cadet-salzburg/EMGShield/README.md

EMGShield
=========

This project deals with the bio signal EMG (Electromyogram) and its potential as a control signal in connection with the Microcontroller-platform Arduino. The platform offers different pluggable modules, so called Shields, where unfortunately a professional EMG-Shield is missing. Due to this fact a first EMG-Shield prototype was developed. This process included the simulation of the electrical circuits, the implementation of these circuits on a breadboard and finally the verification. For this, a ping-pong-game was modified to test the ability of the EMG-signal as control-input. The test-application showed that it’s possible to control a ping-pong-game quite comfortable just by the power of a muscle. This underlines the high controlling-potential of the EMG-signal and motivates for further developments. Consequently, the circuit board, shown in our first video, has now been integrated to an Arduino Shield. The wiring and the software will soon be available online.

credits: Dieter Steininger, Michael Platz, Roland Haring, Christopher Lindinger, Veronika Pauser, Roland Aigner, Otto Naderer

http://www.cadet.at/2012/04/17/emg-shield/

License
=========

CADET - Center for Advances in Digital Entertainment Technologies
Copyright 2011 University of Applied Science Salzburg / MultiMediaTechnology & Ars Electronica Futurelab

http://www.cadet.at
http://multimediatechnology.at
http://research.aec.at

Licensed under the Apache License, Version 2.0 (the "License");
you may not use this file except in compliance with the License.
You may obtain a copy of the License at

http://www.apache.org/licenses/LICENSE-2.0

Unless required by applicable law or agreed to in writing, software
distributed under the License is distributed on an "AS IS" BASIS,
WITHOUT WARRANTIES OR CONDITIONS OF ANY KIND, either express or implied.
See the License for the specific language governing permissions and
limitations under the License.

CADET - Center for Advances in Digital Entertainment Technologies
funded by the Austrian Research Promotion Agency (http://www.ffg.at)
