cadet-salzburg/EMGShield/CAD/EMG_Shield_v.1.2.brd

## EAGLE design CAD/EMG_Shield_v.1.2.brd (2012-10-18)

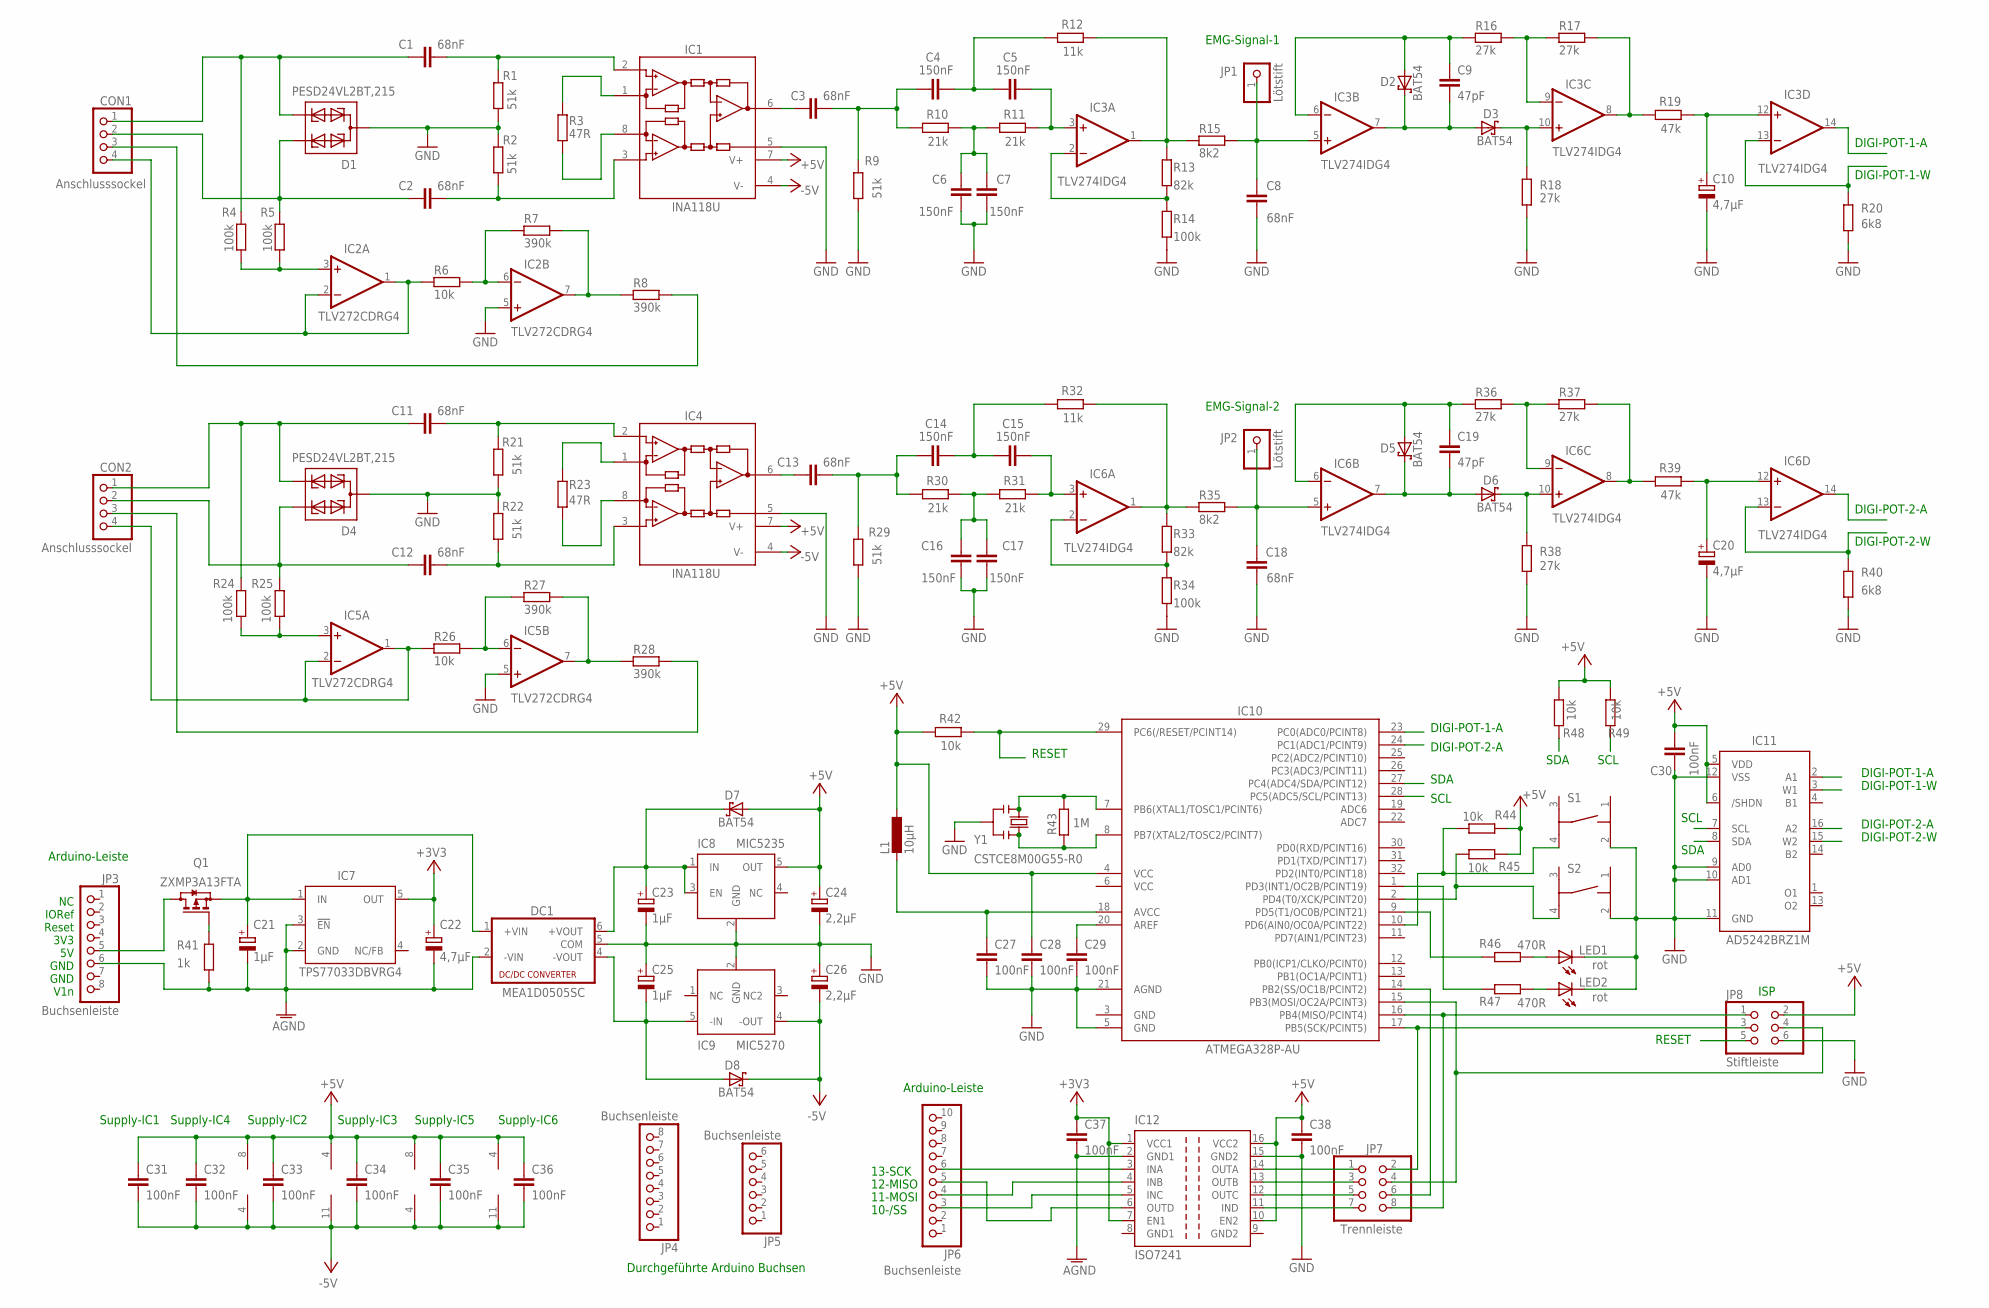
[picture p1: schematic EMG_Shield_v.1.2.sch]

Parts:
C1, C2, C3, C8, C11, C12, C13, C18: 68nF; C0603
C4, C5, C6, C7, C14, C15, C16, C17: 150nF; C0603
C9, C19: 47pF; C0603
C10, C20, C22: 4,7µF; CT3216
C21, C23, C25: 1µF; CT3216
C24, C26: 2,2µF; CT3216
C27, C28, C29, C30, C31, C32, C33, C34, C35, C36, C37, C38: 100nF; C0603
CON1, CON2: Anschlusssockel; 1X04/90
D1, D4: PESD24VL2BT,215; SOT23
D2, D3, D5, D6, D7, D8: BAT54; SOT23
DC1: MEA1D0505SC; NMA
IC1, IC4: INA118U; SO08
IC2, IC5: TLV272CDRG4; SO08
IC3, IC6: TLV274IDG4; SO14
IC7: TPS77033DBVRG4; SOT23-DBV
IC8: MIC5235; SOT23-5
IC9: MIC5270; SOT23-5
IC10: ATMEGA328P-AU; TQFP32-08
IC11: AD5242BRZ1M; SOIC16N
IC12: ISO7241; SO-16DW
JP1, JP2: Lötstift; 1X01
JP3, JP4: Buchsenleiste; SMARTPRJ_1X08-TH
JP5: Buchsenleiste; SMARTPRJ_1X06-TH
JP6: Buchsenleiste; SMARTPRJ_1X10
JP7: Trennleiste; 2X04
JP8: Stiftleiste; 2X03
L1: 10µH; R0805
LED1, LED2: rot; CHIP-LED0805
Q1: ZXMP3A13FTA; SOT23
R1, R2, R9, R21, R22, R29: 51k; R0603
R3, R23: 47R; R0603
R4, R5, R14, R24, R25, R34: 100k; R0603
R6, R26, R42, R44, R45, R48, R49: 10k; R0603
R7, R8, R27, R28: 390k; R0603
R10, R11, R30, R31: 21k; R0603
R12, R32: 11k; R0603
R13, R33: 82k; R0603
R15, R35: 8k2; R0603
R16, R17, R18, R36, R37, R38: 27k; R0603
R19, R39: 47k; R0603
R20, R40: 6k8; R0603
R41: 1k; R0603
R43: 1M; R0603
R46, R47: 470R; R0603
S1, S2: TASTER-9314_SMD
Y1: CSTCE8M00G55-R0; SMARTPRJ_RESONATOR

Connections:
+3V3: C22.+, C37.1, IC7.5 (OUT), IC12.1 (VCC1), IC12.7 (EN1)
+5V: C24.+, C28.1, C30.1, C31.1, C32.1, C33.1, C34.1, C35.1, C36.1, C38.1, D7.1 (A), IC1.7 (V+), IC2.8 (V+), IC3.4 (V+), IC4.7 (V+), IC5.8 (V+), IC6.4 (V+), IC8.5 (OUT), IC10.4 (VCC), IC11.5 (VDD), IC11.6 (/SHDN), IC12.10 (EN2), IC12.16 (VCC2), JP8.2, L1.1, R42.2, R44.2, R45.2, R48.1, R49.1
-5V: C26.-, C31.2, C32.2, C33.2, C34.2, C35.2, C36.2, D8.3 (C), IC1.4 (V-), IC2.4 (V-), IC3.11 (V-), IC4.4 (V-), IC5.4 (V-), IC6.11 (V-), IC9.4 (-OUT)
AGND: C21.-, C22.-, C37.2, DC1.2 (-VIN), IC7.2 (GND), IC7.3 (!EN), IC12.2 (GND1), JP3.6, R41.2
DIGI-POT-1-A: IC3.14 (OUT), IC10.23 (PC0(ADC0/PCINT8)), IC11.2 (A1)
DIGI-POT-1-W: IC3.13 (-IN), IC11.3 (W1), R20.1
DIGI-POT-2-A: IC6.14 (OUT), IC10.24 (PC1(ADC1/PCINT9)), IC11.16 (A2)
DIGI-POT-2-W: IC6.13 (-IN), IC11.15 (W2), R40.1
GND: C6.1, C7.1, C8.1, C10.-, C16.1, C17.1, C18.1, C20.-, C23.-, C24.-, C25.+, C26.+, C27.2, C28.2, C29.2, C30.2, C38.2, D1.3 (GROUND), D4.3 (GROUND), DC1.5 (COM), IC1.5 (REF), IC2.5 (+IN), IC4.5 (REF), IC5.5 (+IN), IC8.2 (GND), IC9.2 (GND), IC10.3 (GND), IC10.5 (GND), IC10.21 (AGND), IC11.9 (AD0), IC11.10 (AD1), IC11.11 (GND), IC11.12 (VSS), IC12.15 (GND2), JP8.6, LED1.C, LED2.C, R1.1, R2.2, R9.1, R14.2, R18.1, R20.2, R21.1, R22.2, R29.1, R34.2, R38.1, R40.2, S1.2, S2.2, Y1.2
GND1: IC12.8 (GND1)
GND2: IC12.9 (GND2)
unnamed: C1.1, CON1.1, D1.2 (PROTECT2), R4.2
unnamed: IC1.1 (RG), R3.1
unnamed: C1.2, IC1.2 (-IN), R1.2
unnamed: CON1.4, IC2.1 (OUT), IC2.2 (-IN), R6.1
unnamed: C2.2, IC1.3 (+IN), R2.1
unnamed: C2.1, CON1.2, D1.1 (PROTECT1), R5.2
unnamed: IC2.6 (-IN), R6.2, R7.1
unnamed: IC2.3 (+IN), R4.1, R5.1
unnamed: IC2.7 (OUT), R7.2, R8.1
unnamed: CON1.3, R8.2
unnamed: IC4.1 (RG), R23.1
unnamed: IC10.14 (PB2(SS/OC1B/PCINT2)), JP7.6
unnamed: IC1.8 (RG), R3.2
unnamed: C11.1, CON2.1, D4.2 (PROTECT2), R24.2
unnamed: C3.1, IC1.6 (OUT)
unnamed: C3.2, C4.1, R9.2, R10.2
unnamed: IC3.1 (OUT), R12.1, R13.1, R15.1
unnamed: C4.2, C5.1, R12.2
unnamed: C5.2, IC3.3 (+IN), R11.1
unnamed: C6.2, C7.2, R10.1, R11.2
unnamed: IC3.2 (-IN), R13.2, R14.1
unnamed: C11.2, IC4.2 (-IN), R21.2
unnamed: C8.2, IC3.5 (+IN), JP1.1, R15.2
unnamed: C9.2, D2.3 (C), D3.1 (A), IC3.7 (OUT)
unnamed: D3.3 (C), IC3.10 (+IN), R18.2
unnamed: C9.1, D2.1 (A), IC3.6 (-IN), R16.1
unnamed: IC3.9 (-IN), R16.2, R17.1
unnamed: IC3.8 (OUT), R17.2, R19.2
unnamed: C10.+, IC3.12 (+IN), R19.1
unnamed: C21.+, DC1.1 (+VIN), IC7.1 (IN), Q1.2 (S)
unnamed: C12.2, IC4.3 (+IN), R22.1
unnamed: C12.1, CON2.2, D4.1 (PROTECT1), R25.2
unnamed: IC5.3 (+IN), R24.1, R25.1
unnamed: CON2.4, IC5.1 (OUT), IC5.2 (-IN), R26.1
unnamed: IC5.6 (-IN), R26.2, R27.1
unnamed: IC5.7 (OUT), R27.2, R28.1
unnamed: CON2.3, R28.2
unnamed: IC12.14 (OUTA), JP7.1
unnamed: IC12.4 (INB), JP6.4
unnamed: IC4.8 (RG), R23.2
unnamed: IC12.13 (OUTB), JP7.3
unnamed: C13.1, IC4.6 (OUT)
unnamed: C13.2, C14.1, R29.2, R30.2
unnamed: C14.2, C15.1, R32.2
unnamed: C15.2, IC6.3 (+IN), R31.1
unnamed: C16.2, C17.2, R30.1, R31.2
unnamed: IC6.1 (OUT), R32.1, R33.1, R35.1
unnamed: IC6.2 (-IN), R33.2, R34.1
unnamed: C18.2, IC6.5 (+IN), JP2.1, R35.2
unnamed: C19.2, D5.3 (C), D6.1 (A), IC6.7 (OUT)
unnamed: D6.3 (C), IC6.10 (+IN), R38.2
unnamed: C19.1, D5.1 (A), IC6.6 (-IN), R36.1
unnamed: IC6.9 (-IN), R36.2, R37.1
unnamed: IC6.8 (OUT), R37.2, R39.2
unnamed: C20.+, IC6.12 (+IN), R39.1
unnamed: C23.+, D7.3 (C), DC1.6 (+VOUT), IC8.1 (IN), IC8.3 (EN)
unnamed: JP3.5, Q1.3 (D)
unnamed: IC10.9 (PD5(T1/OC0B/PCINT21)), R46.2
unnamed: C25.-, D8.1 (A), DC1.4 (-VOUT), IC9.5 (-IN)
unnamed: IC10.10 (PD6(AIN0/OC0A/PCINT22)), R44.1, S1.4
unnamed: Q1.1 (G), R41.1
unnamed: IC10.2 (PD4(T0/XCK/PCINT20)), R45.1, S2.4
unnamed: LED1.A, R46.1
unnamed: IC10.1 (PD3(INT1/OC2B/PCINT19)), R47.2
unnamed: LED2.A, R47.1
unnamed: IC12.6 (OUTD), JP6.5
unnamed: IC10.17 (PB5(SCK/PCINT5)), JP7.2, JP8.3
unnamed: IC10.15 (PB3(MOSI/OC2A/PCINT3)), JP7.4, JP8.4
unnamed: IC12.12 (OUTC), JP7.5
unnamed: IC10.16 (PB4(MISO/PCINT4)), JP7.8, JP8.1
unnamed: IC12.3 (INA), JP6.6
unnamed: IC12.5 (INC), JP6.3
unnamed: IC12.11 (IND), JP7.7
unnamed: C27.1, IC10.18 (AVCC), L1.2
unnamed: IC10.7 (PB6(XTAL1/TOSC1/PCINT6)), R43.1, Y1.1
unnamed: IC10.8 (PB7(XTAL2/TOSC2/PCINT7)), R43.2, Y1.3
unnamed: C29.1, IC10.20 (AREF)
RESET: IC10.29 (PC6(/RESET/PCINT14)), JP8.5, R42.1
SCL: IC10.28 (PC5(ADC5/SCL/PCINT13)), IC11.7 (SCL), R49.2
SDA: IC10.27 (PC4(ADC4/SDA/PCINT12)), IC11.8 (SDA), R48.2
VCC: IC10.6 (VCC)

Notes on the sheet:
DIGI-POT-1-A
DIGI-POT-1-W
DIGI-POT-2-W
DIGI-POT-2-A
Reset
IORef
3V3
GND
V1n
Arduino-Leiste
13-SCK
12-MISO
10-/SS
Supply-IC2
Supply-IC3
Supply-IC5
Supply-IC6
Supply-IC1
Supply-IC4
Durchgeführte Arduino Buchsen
EMG-Signal-1
EMG-Signal-2
RESET
SDA
SCL
ISP
11-MOSI

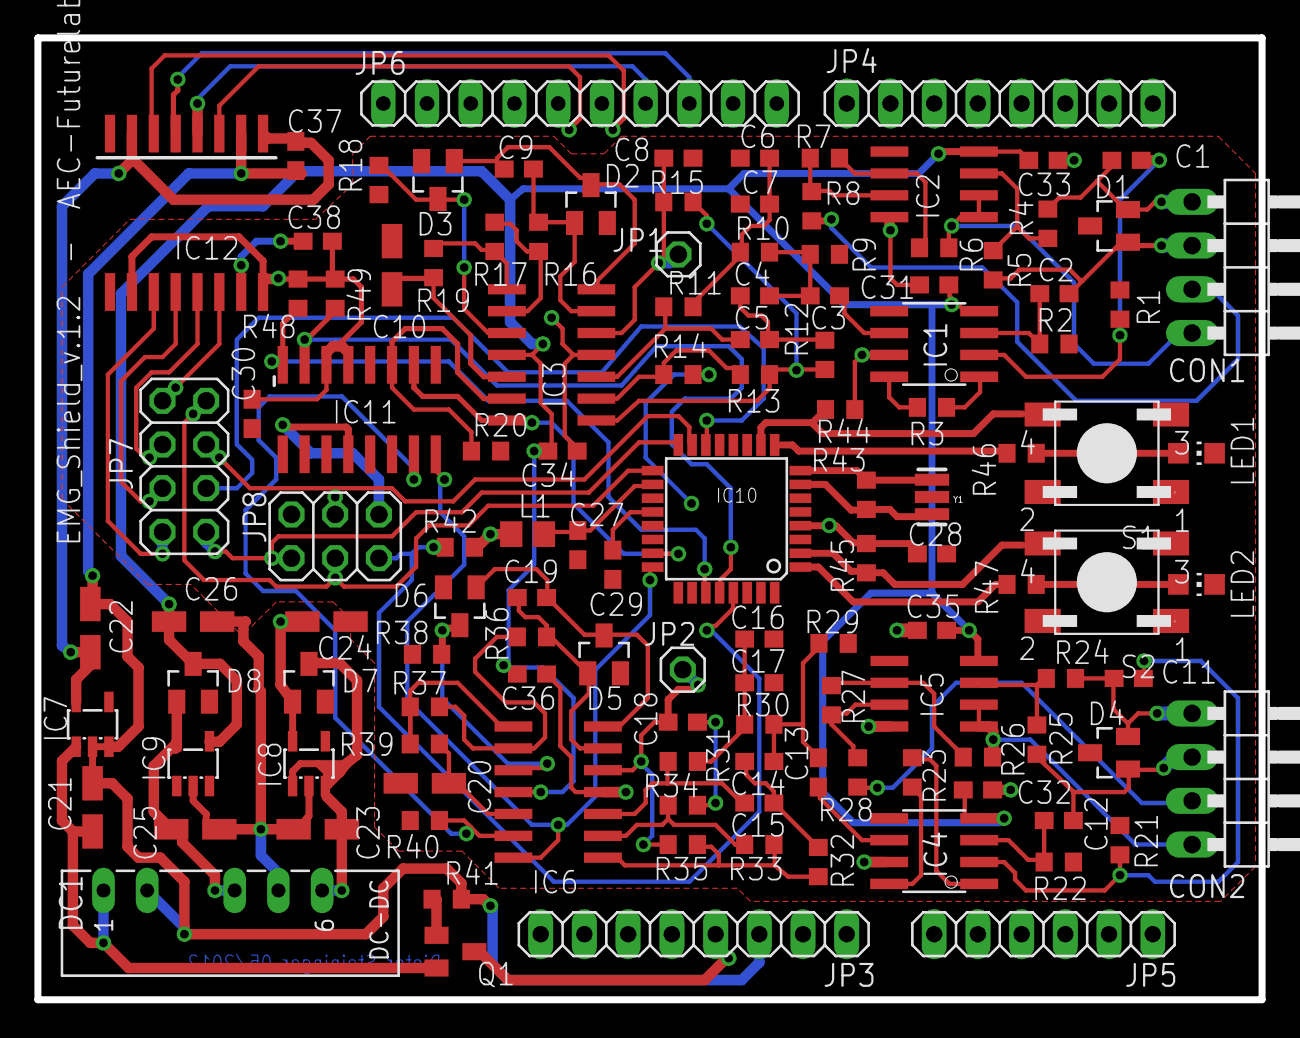
[picture p2: board EMG_Shield_v.1.2.brd from above]

Board: 2 copper layers, 71.1 x 55.9 mm, 125 parts (0 on the bottom side), 89 nets.
