cadet-salzburg/EMGShield/(commit log)

2012-09-26 update of license, removed unneeded files
    [TcfTransactionLog.csv]
2012-10-18 Added CAD files (.sch, .brd)
    CAD files of EMGShield v1.2 Schematic and Board Design;
    created by Dieter Steininger at the Ars Electronica Futurelab using
    EAGLE v6.2.0
    [EMG_Shield_v.1.2.brd, EMG_Shield_v.1.2.sch]
